Thalesardc/PBLE02/PBLE02/VH3/3D/LCD_visao1.JPG

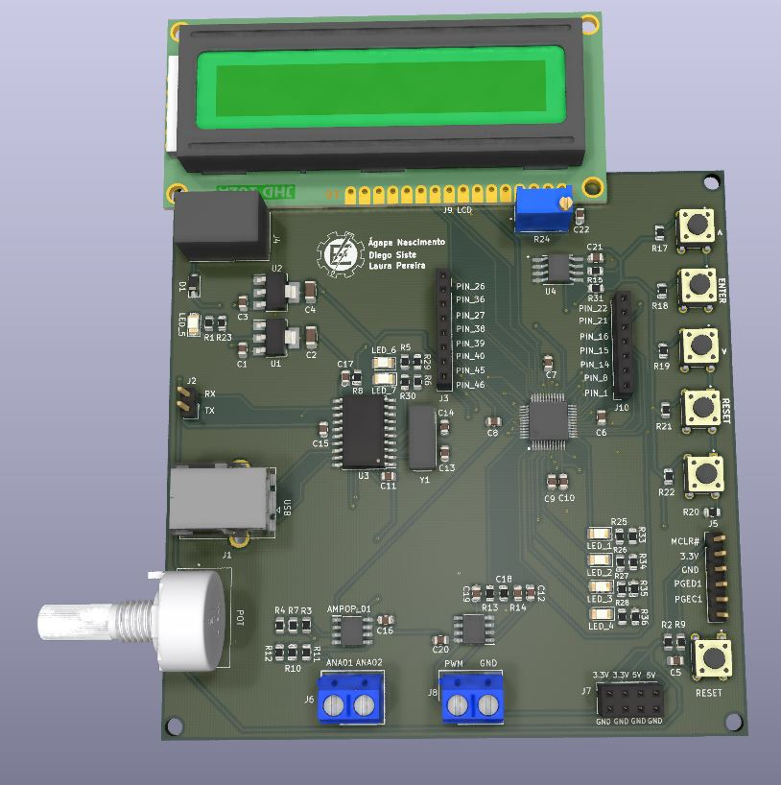
PBLE02/VH3/3D/LCD_visao1.JPG
