Thalesardc/PBLE02/PBLE02/VH3/3D/LCD_visao2.JPG

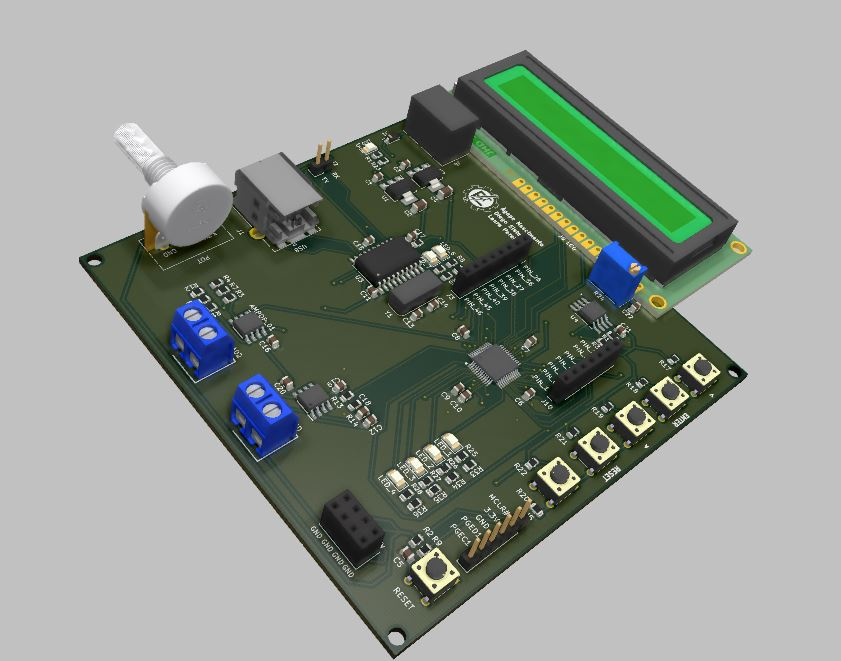
PBLE02/VH3/3D/LCD_visao2.JPG
