Thalesardc/PBLE02/PBLE02/VH3/3D/visao3D.JPG

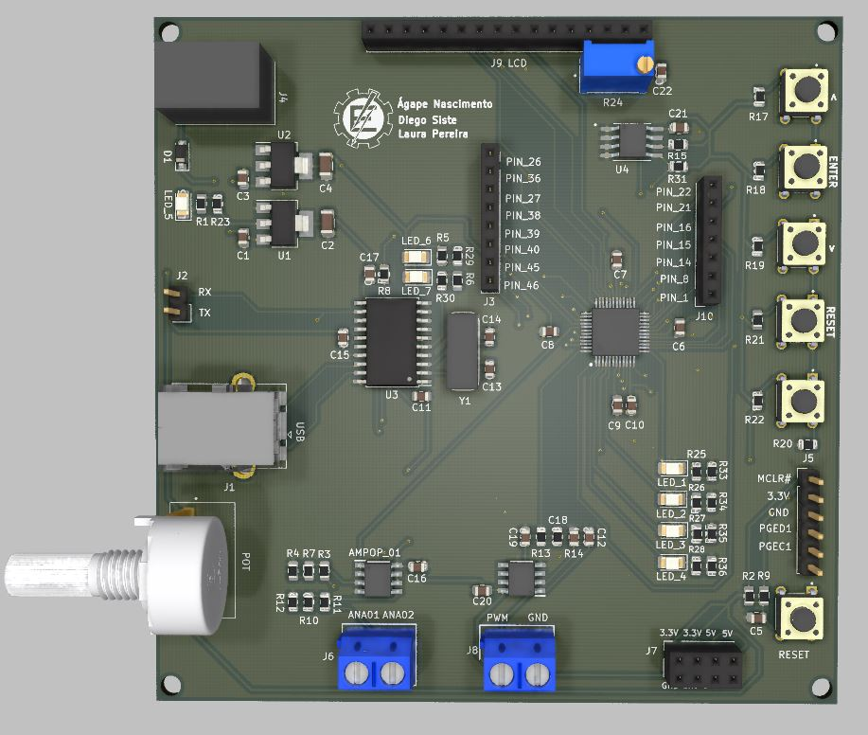
PBLE02/VH3/3D/visao3D.JPG
