Thalesardc/PBLE02/PBLE02/VH3/DIAGRAMAS/diagrama_de_estados.png

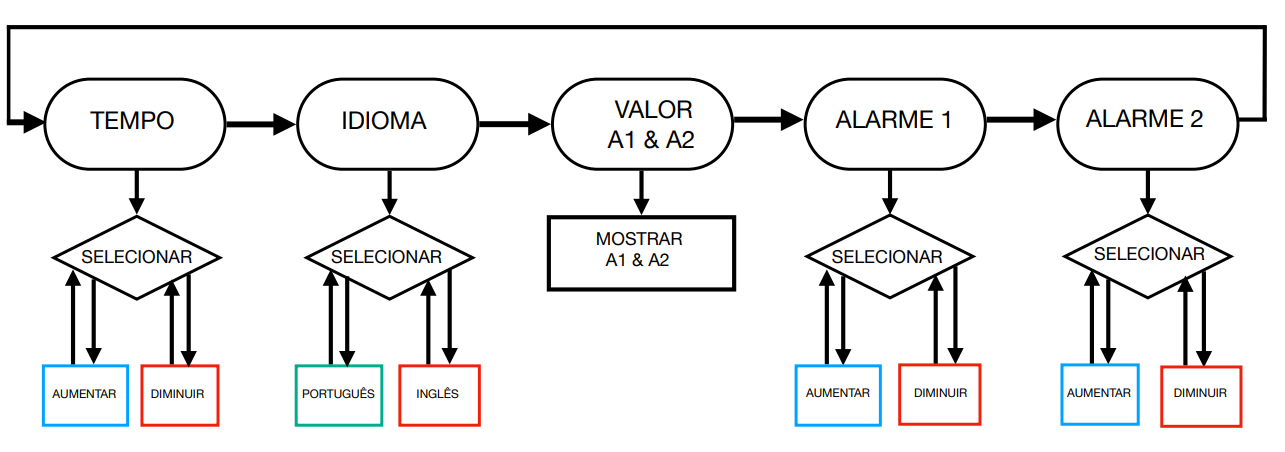
PBLE02/VH3/DIAGRAMAS/diagrama_de_estados.png
