Thalesardc/PBLE02/PBLE02/VH3/DIAGRAMAS/UML.jpeg

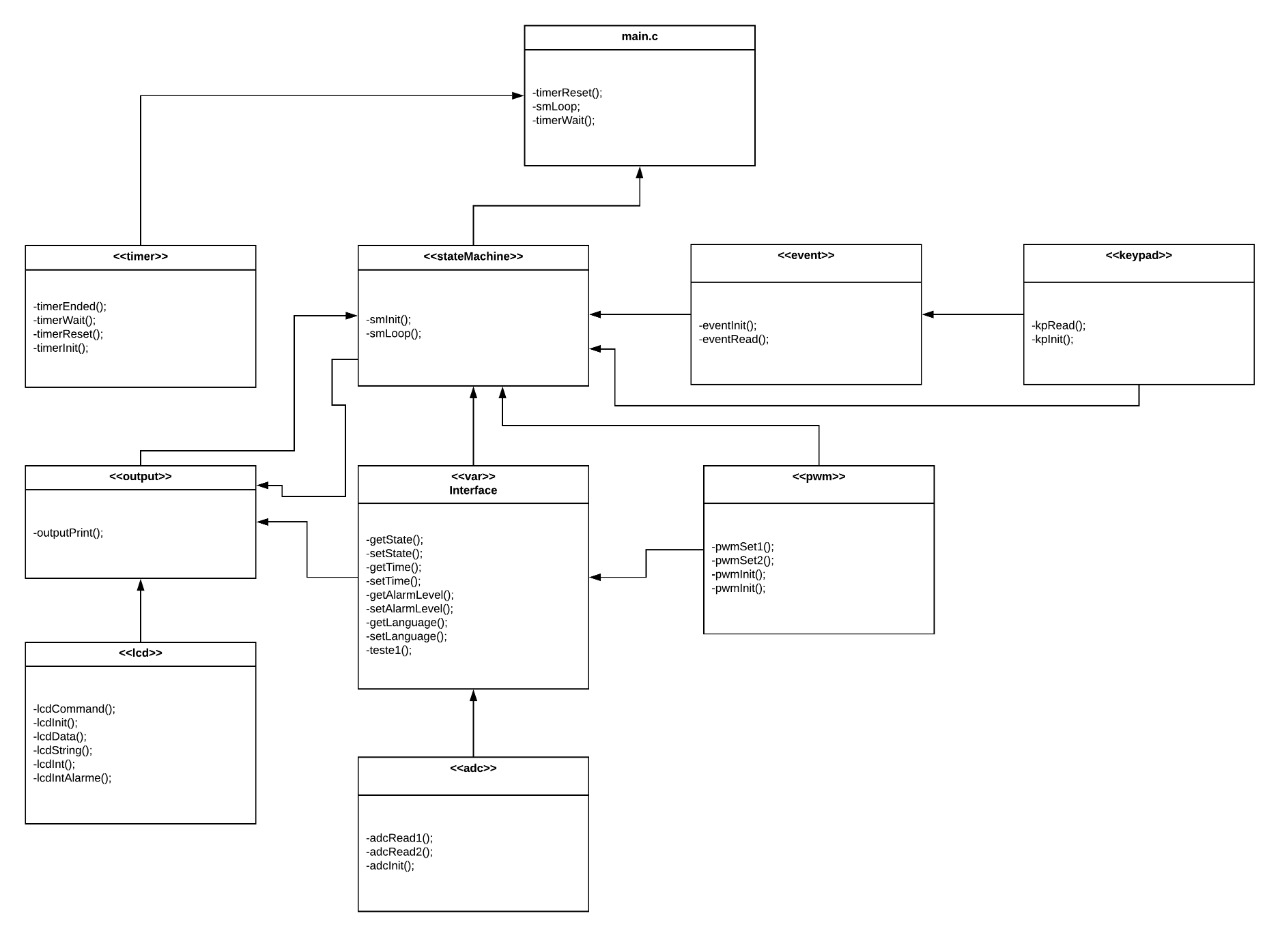
PBLE02/VH3/DIAGRAMAS/UML.jpeg
