Thalesardc/PBLE02/PBLE02/VH3/COMPONENTES/3D/PIC32MM0256GPM048-I_PT.stp

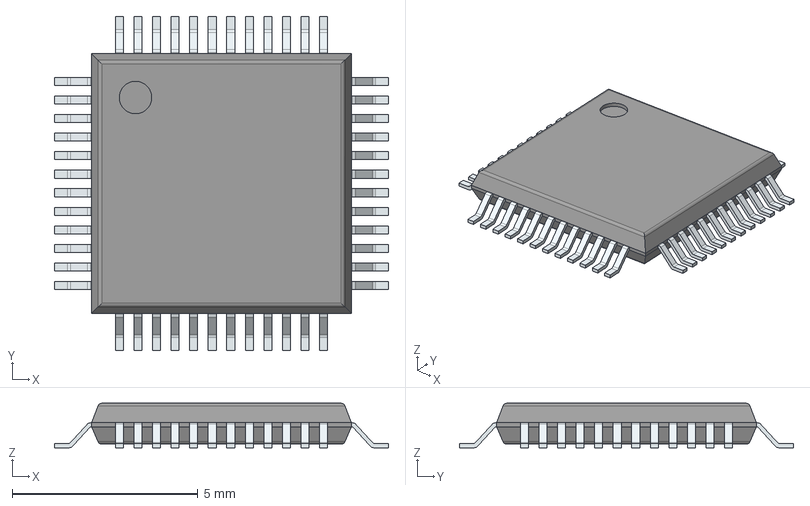
[picture p25: CAD file, 2022-07-13]
PBLE02/VH3/COMPONENTES/3D/PIC32MM0256GPM048-I_PT.stp
9.00 x 9.00 x 1.20 mm
PinsArrayLR
PinsArrayTB
