Thalesardc/PBLE02/PBLE02/VH3/COMPONENTES/3D/3296W-1-250--3DModel-STEP-56544.STEP

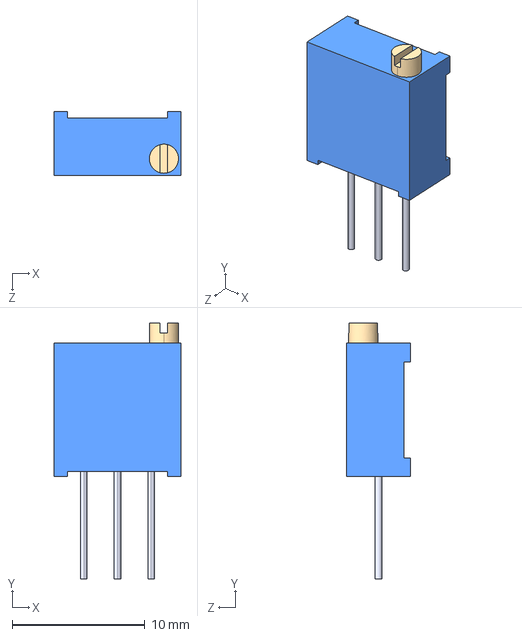
[picture p26: CAD file, 2022-07-13]
PBLE02/VH3/COMPONENTES/3D/3296W-1-250--3DModel-STEP-56544.STEP
9.53 x 19.3 x 4.83 mm
