Thalesardc/PBLE02/PBLE02/VH3/COMPONENTES/3D/CUI_DEVICES_PJ-002AH-SMT-TR.step

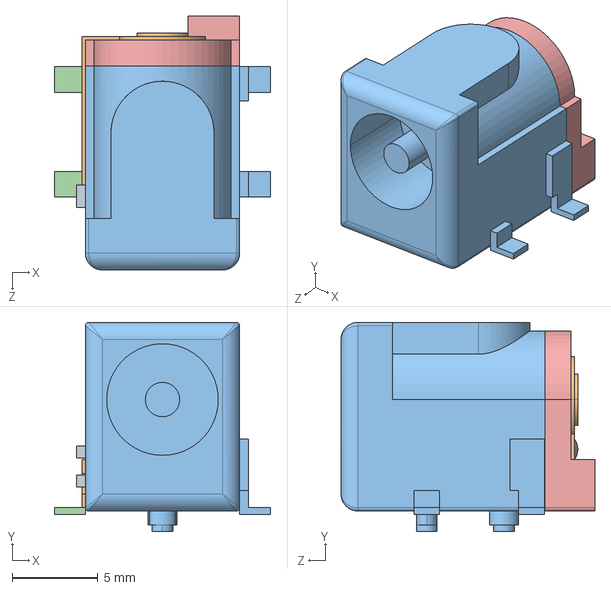
[picture p27: CAD file, 2022-07-13]
PBLE02/VH3/COMPONENTES/3D/CUI_DEVICES_PJ-002AH-SMT-TR.step
12.6 x 12.2 x 14.8 mm
