Thalesardc/PBLE02/PBLE02/VH3/COMPONENTES/3D/DPAK-L.step

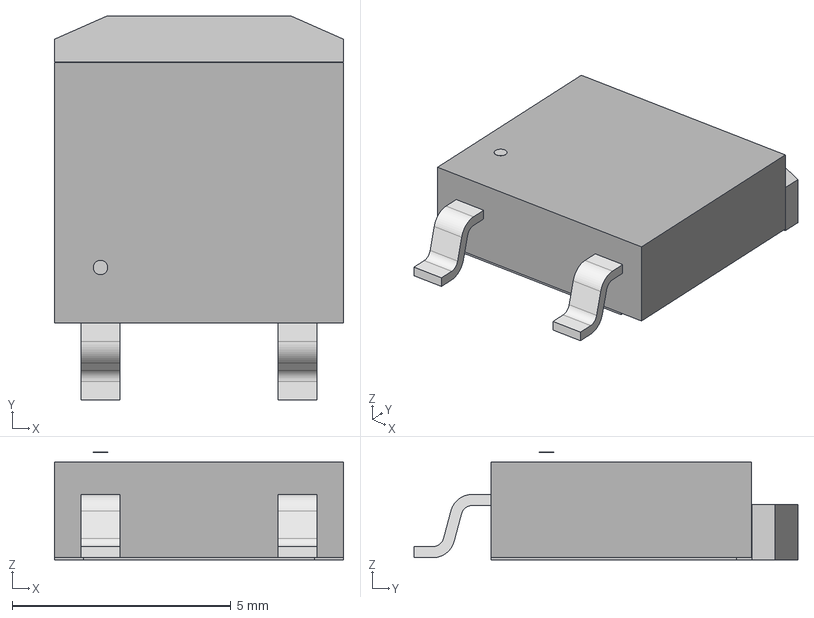
[picture p28: CAD file, 2022-07-13]
PBLE02/VH3/COMPONENTES/3D/DPAK-L.step
6.60 x 8.77 x 2.47 mm
