Thalesardc/PBLE02/PBLE02/VH3/COMPONENTES/3D/User Library-2_54mm Male Header (4x2).STEP

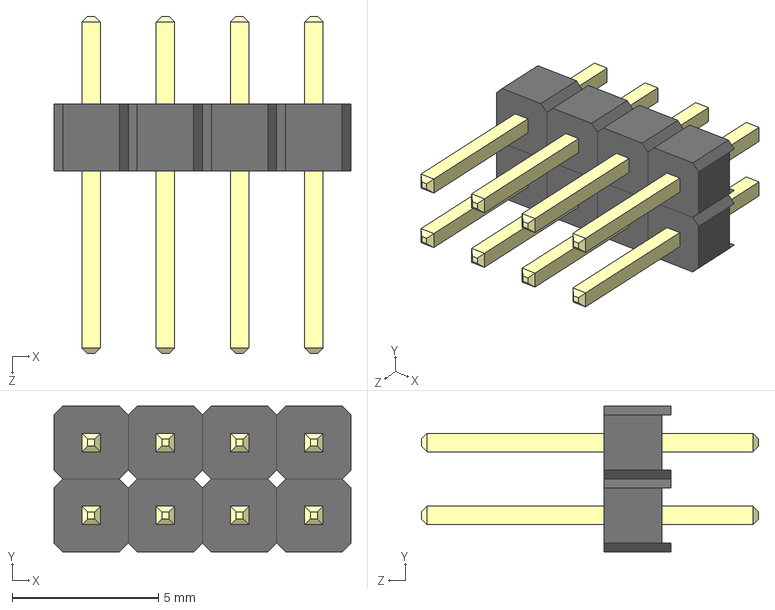
[picture p29: CAD file, 2022-07-13]
PBLE02/VH3/COMPONENTES/3D/User Library-2_54mm Male Header (4x2).STEP
10.2 x 4.98 x 11.5 mm
User Library-Header_Male_4Pin_PinArray x 2
User Library-Header_Male_4Pin_BodyArray x 2
