Thalesardc/PBLE02/PBLE02/VH3/COMPONENTES/3D/PJ-002AH.stp

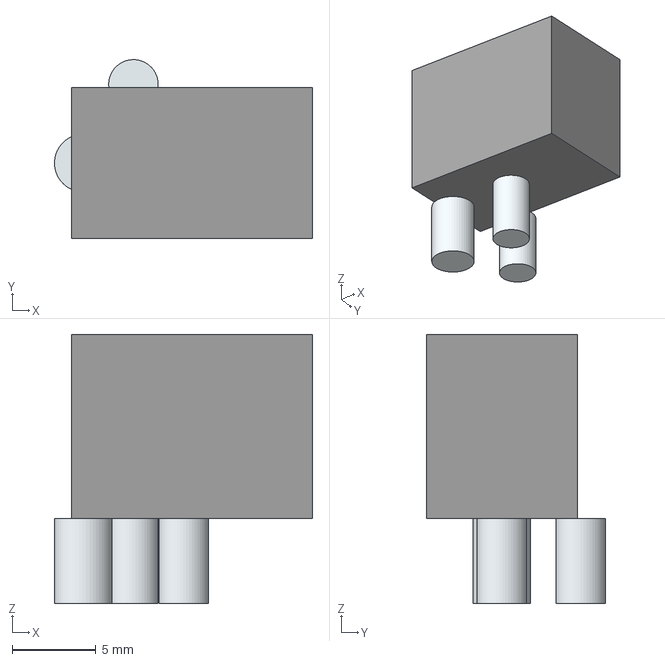
[picture p31: CAD file, 2022-07-13]
PBLE02/VH3/COMPONENTES/3D/PJ-002AH.stp
15.4 x 10.7 x 16.1 mm
Leads x 3
