Thalesardc/PBLE02/PBLE02/VH3/COMPONENTES/3D/47K Potenziometer.step

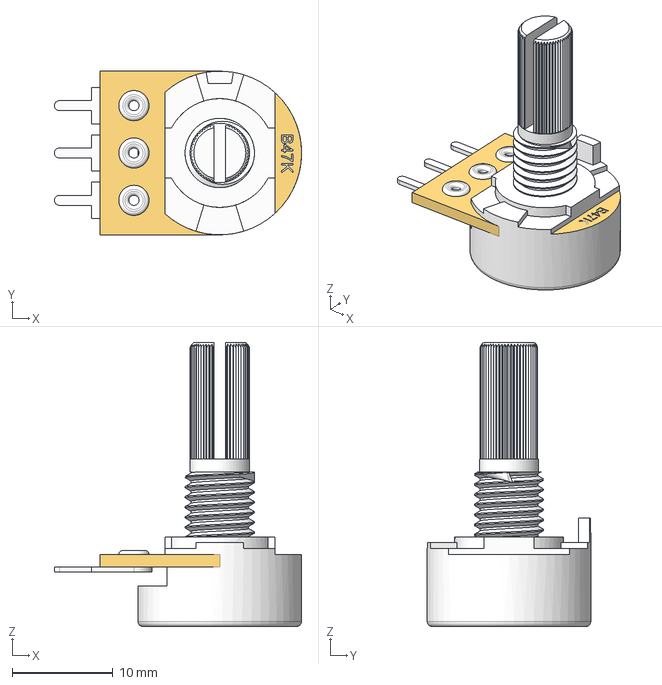
[picture p32: CAD file, 2022-07-13]
PBLE02/VH3/COMPONENTES/3D/47K Potenziometer.step
24.6 x 16.2 x 28.2 mm
