Thalesardc/PBLE02/PBLE02/VH3/COMPONENTES/3D/c-292304-1-b-3d.igs

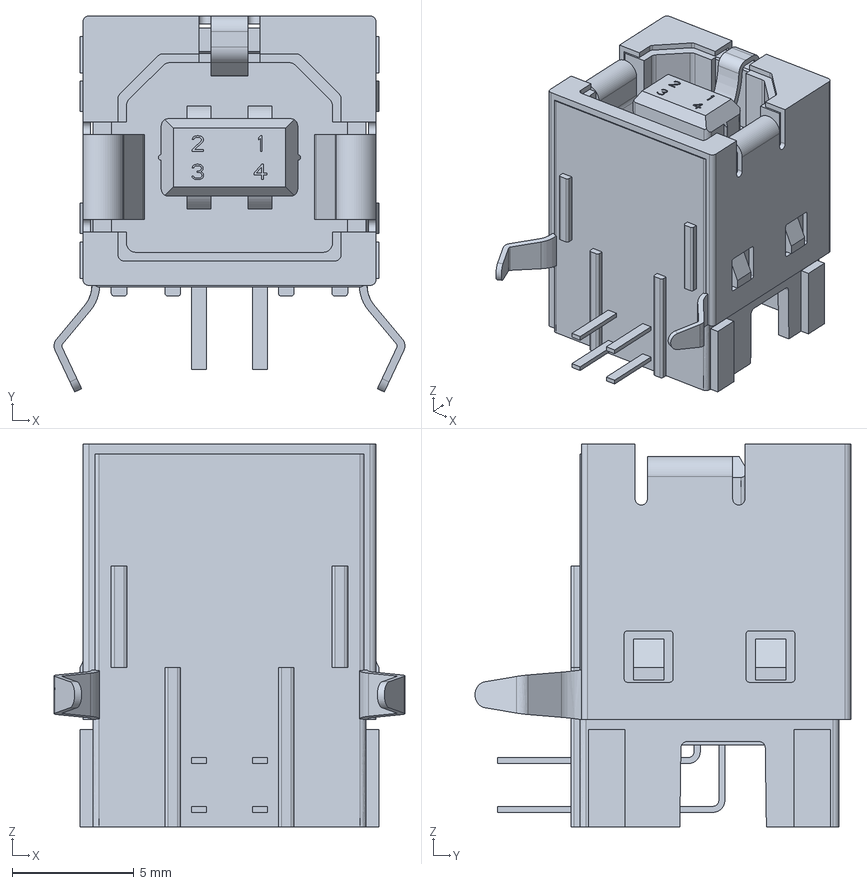
[picture p33: CAD file, 2022-07-13]
PBLE02/VH3/COMPONENTES/3D/c-292304-1-b-3d.igs
14.4 x 15.4 x 15.7 mm
