Thalesardc/PBLE02/PBLE02/VH3/COMPONENTES/3D/ATS12A.stp

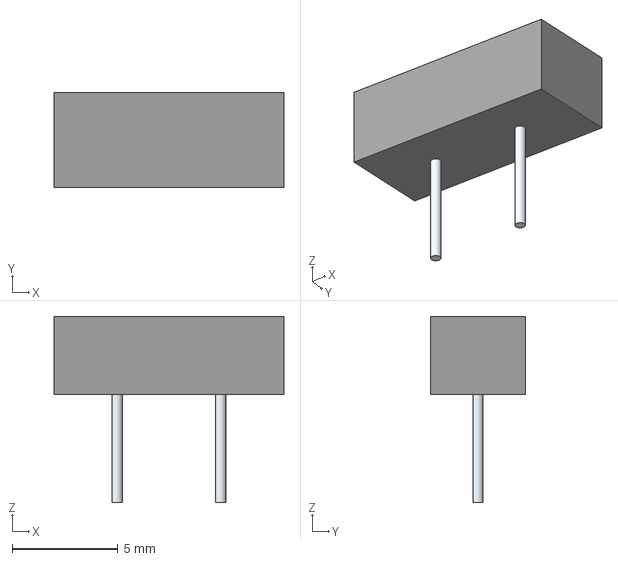
[picture p35: CAD file, 2022-07-13]
PBLE02/VH3/COMPONENTES/3D/ATS12A.stp
10.8 x 4.50 x 8.78 mm
Leads x 2
