Thalesardc/PBLE02/PBLE02/VH3/COMPONENTES/3D/LM358DG.stp

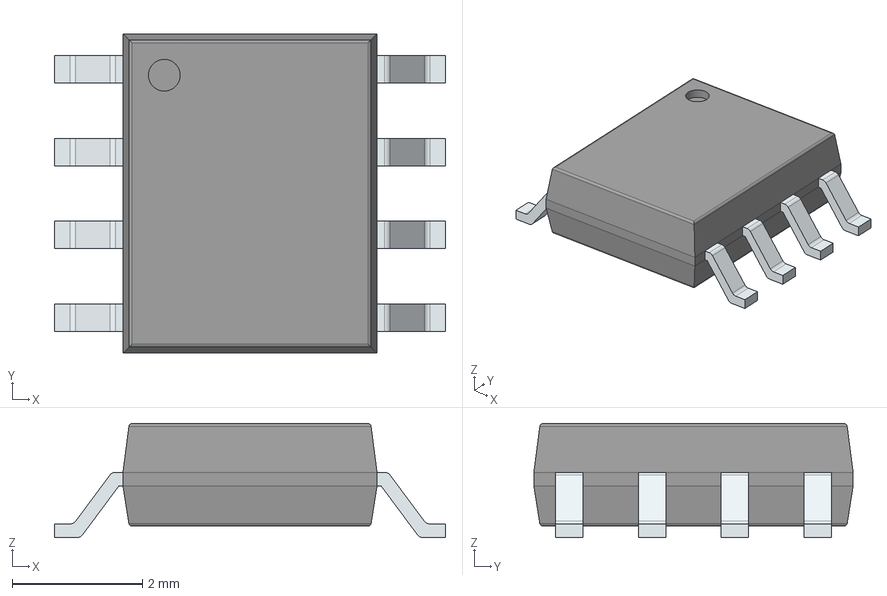
[picture p36: CAD file, 2022-07-13]
PBLE02/VH3/COMPONENTES/3D/LM358DG.stp
6.00 x 4.90 x 1.75 mm
PinsArrayLR
