Thalesardc/PBLE02/PBLE02/VH3/COMPONENTES/3D/User Library-LCD 16x2 JHD162A.STEP

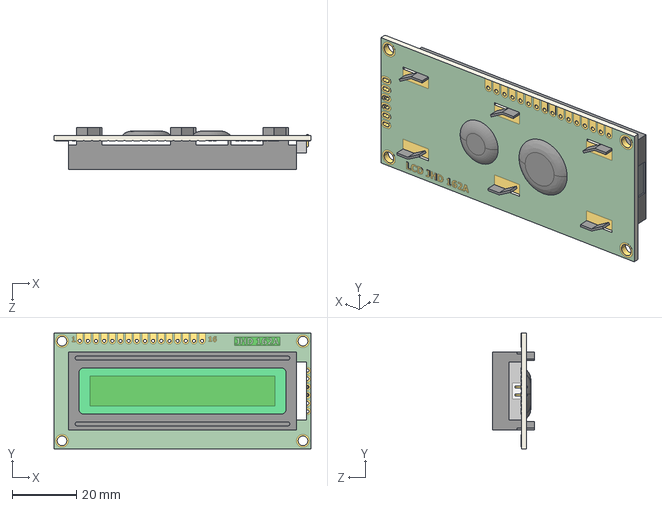
[picture p37: CAD file, 2022-07-13]
PBLE02/VH3/COMPONENTES/3D/User Library-LCD 16x2 JHD162A.STEP
80.0 x 36.0 x 13.2 mm
