Thalesardc/PBLE02/PBLE02/VH3/COMPONENTES/3D/1825910-6--3DModel-STEP-56544.STEP

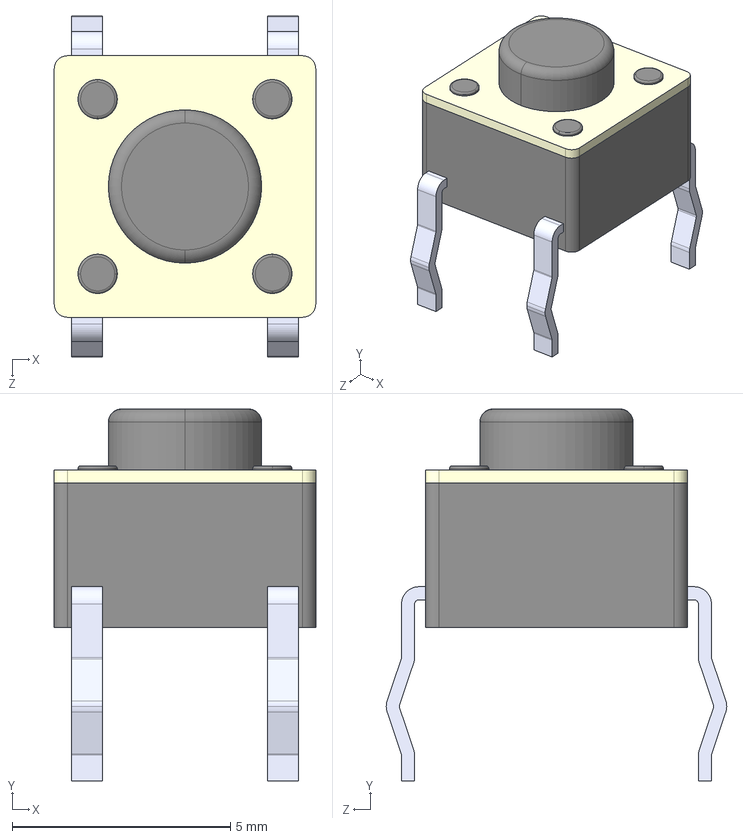
[picture p38: CAD file, 2022-07-13]
PBLE02/VH3/COMPONENTES/3D/1825910-6--3DModel-STEP-56544.STEP
5.99 x 8.52 x 7.80 mm
