Thalesardc/PBLE02/(list of files, cad)

Other CAD files:
PBLE02/VH3/COMPONENTES/3D/PJ-002AH.stl
