Thalesardc/PBLE02/PBLE02/Doc/MANUAL.pdf

# Manual do usuário

- Apresentação da placa | pág.02
- Instruções de uso | pág.03
- Contato dos desenvolvedores | pág.16

# Sobre a placa

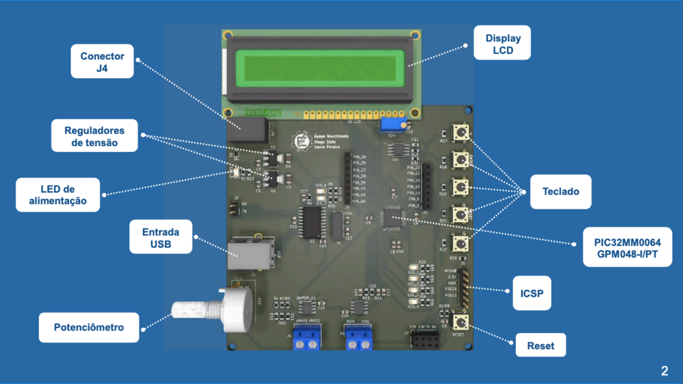
[picture p39: page 3]

•

# > = navega para direita

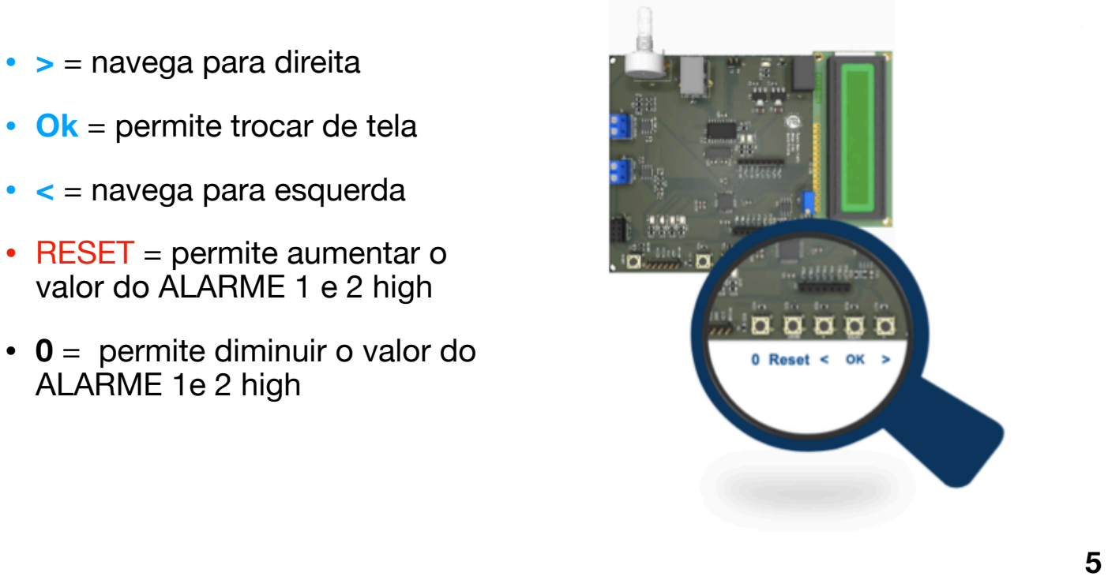
[picture p40: page 4]

# - Ok = permite trocar de tela • < = navega para esquerda • RESET = permite aumentar o

# valor do ALARME 1 e 2 high

•

# 0 = permite diminuir o valor do ALARME 1e 2 high

5

## - O usuário também pode trocar as telas via serial

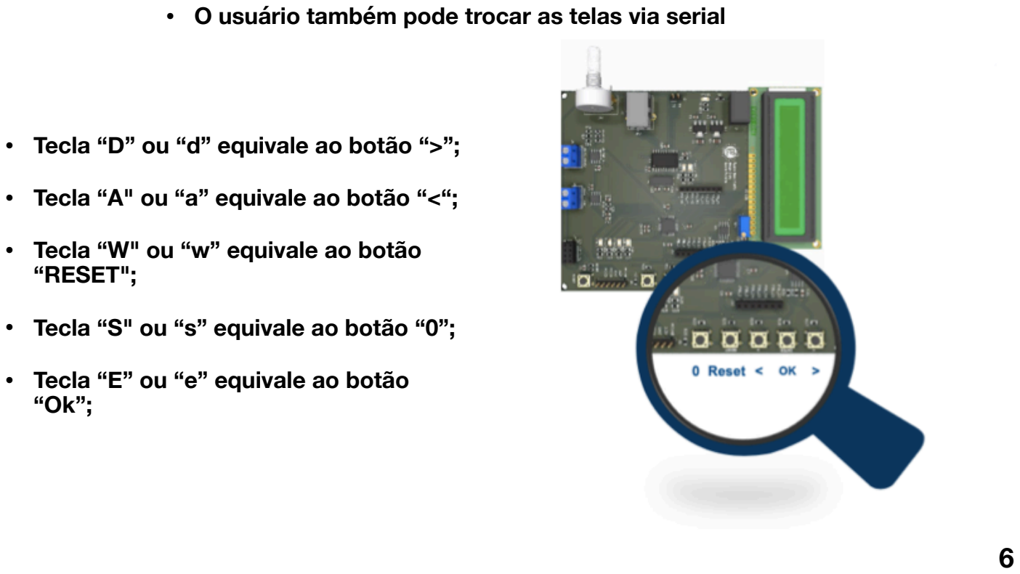
[picture p41: page 5]

- Tecla “D” ou “d” equivale ao botão “>”;
- Tecla “A" ou “a” equivale ao botão “<“;

## - Tecla “W" ou “w” equivale ao botão

“RESET";

- Tecla “S" ou “s” equivale ao botão “0”;

## - Tecla “E” ou “e” equivale ao botão

“Ok”;

6

## INSTRUÇÕES DE USO

Suporta tensão de entrada na faixa de 7 a 12V em corrente continua.

Compatível com conector Jack J4
de diâmetro interno de 2.1mm. | LED 5 sinaliza a presença de alimentação.

## ALIMENTAÇÃO

7

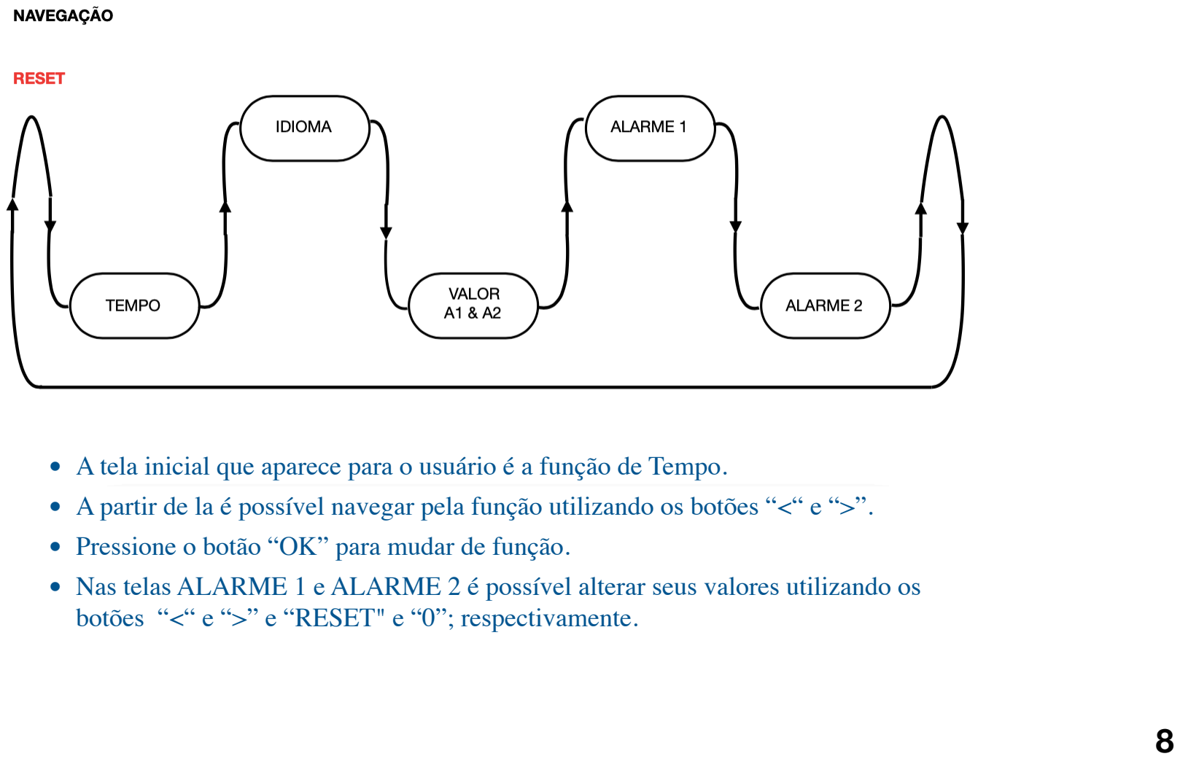
[picture p42: page 7]

- A tela inicial que aparece para o usuário é a função de Tempo.
- A partir de la é possível navegar pela função utilizando os botões “<“ e “>”.
- Pressione o botão “OK” para mudar de função.

### - Nas telas ALARME 1 e ALARME 2 é possível alterar seus valores utilizando os

botões “<“ e “>” e “RESET" e “0”; respectivamente.

8

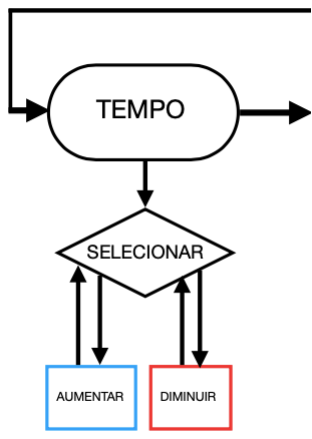
[picture p43: figure]

# - Na função tempo pode-se configurar o delay da máquina

de estado;

# Função Tempo

9

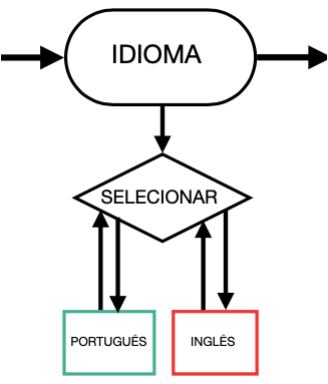
[picture p44: figure]

# - Na função idioma, a primeira tela

será a opção Português.
- Na segunda tela, será Inglês.

# - Para mudar as telas, utilize os botões "<" ou ">"

# Função Idioma

10

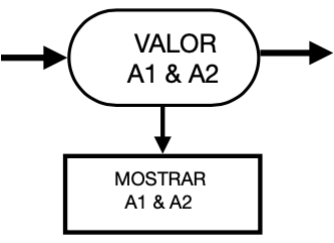
[picture p45: figure]

# - Na Função Valor A1 & A2 é exibido no LCD os valores lidos pelas entradas analógicas da

placa;

# Função Valor A1 & A2

11

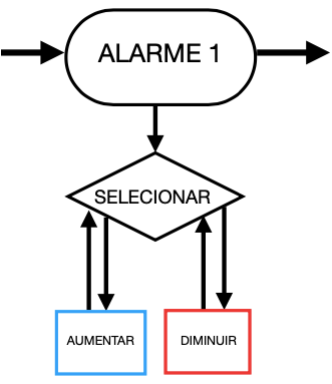
[picture p46: figure]

# - Na Função ALARME 1 e 2 low podemos utilizar as teclas "<" ou “>” para aumentar ou diminuir

seus parâmetros;

# Função ALARME 1

12

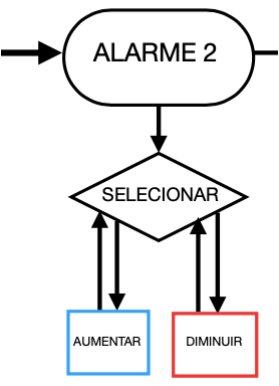
[picture p47: figure]

# - Na Função ALARME 1 e 2 high podemos utilizar as teclas "RESET" ou “0” para aumentar

ou diminuir seus parâmetros;

# Função ALARME 2

13

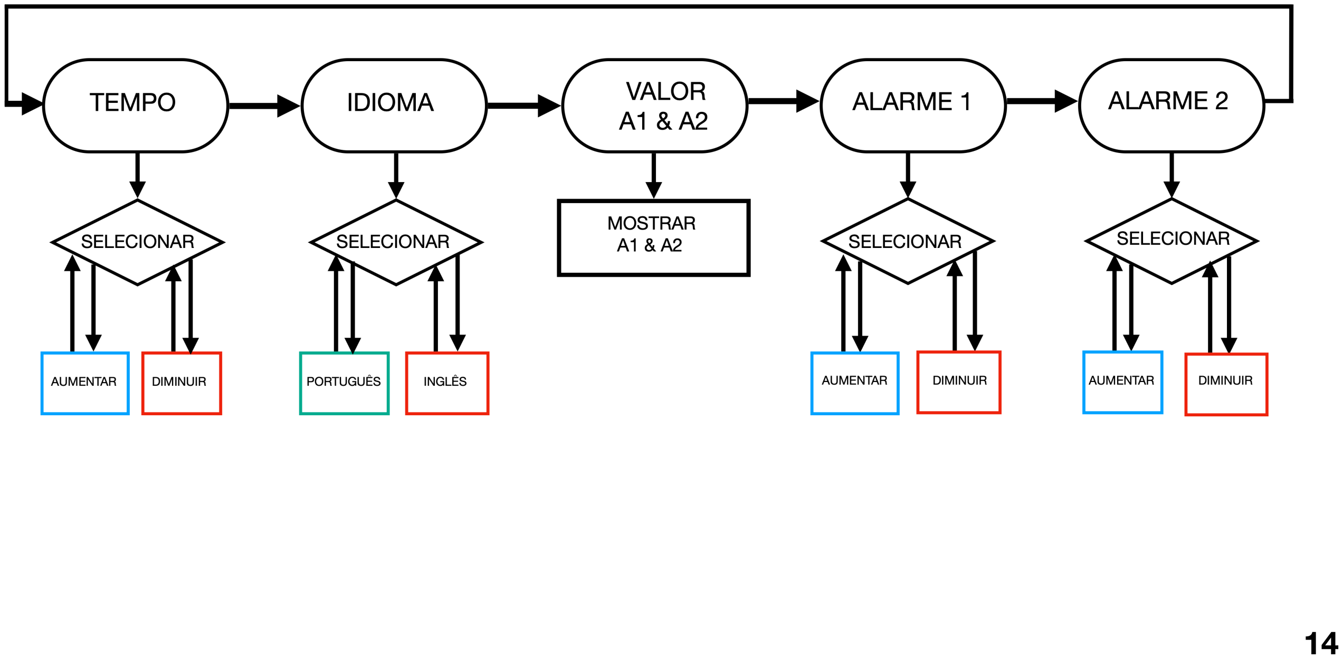
[picture p48: page 13]

14

# Protocolos via Serial

1) Para iniciar o protocolo é necessário utilizar o caractere “#”;
2) Para resetar o protocolo caso haja erro de digitação pode-se usar o caractere “.”;
3) Mensagem T1H “xxxx”;
Com este protocolo pode-se alterar o valor do ALARME 1 high, onde, “xxxx" é o valor digitado pelo usuário.
4) Mensagem T1L “xxxx”;
Com este protocolo pode-se alterar o valor do ALARME 1 low, onde, “xxxx" é o valor digitado pelo usuário.
5) Mensagem T2H “xxxx”;
Com este protocolo pode-se alterar o valor do ALARME 2 high, onde, “xxxx" é o valor digitado pelo usuário.
6) Mensagem T2L “xxxx”;
Com este protocolo pode-se alterar o valor do ALARME 2 low, onde, “xxxx" é o valor digitado pelo usuário.
7) Mensagem Y ”xxxx”;
Com este protocolo pode-se alterar o valor do TEMPO, onde, “xxxx" é o valor digitado pelo usuário.
8) Mensagem PT;
Com este protocolo pode-se alterar o idioma para Português.
9) Mensagem IN;
Com este protocolo pode-se alterar o idioma para Inglês.

15

## Montagem realizada por:

## ADEMILSON RAMOS - 2017019816 (ademilson@engenhariae.com.br) JOÃO CALIL - 2017020890 (jpclemos@unifei.edu.br) THALES CAMPOS - 2019005533 (thales-augusto10@gmail.com)

# OBRIGADO!
