Thalesardc/PBLE02/PBLE02/Doc/VH3_esquemático.pdf

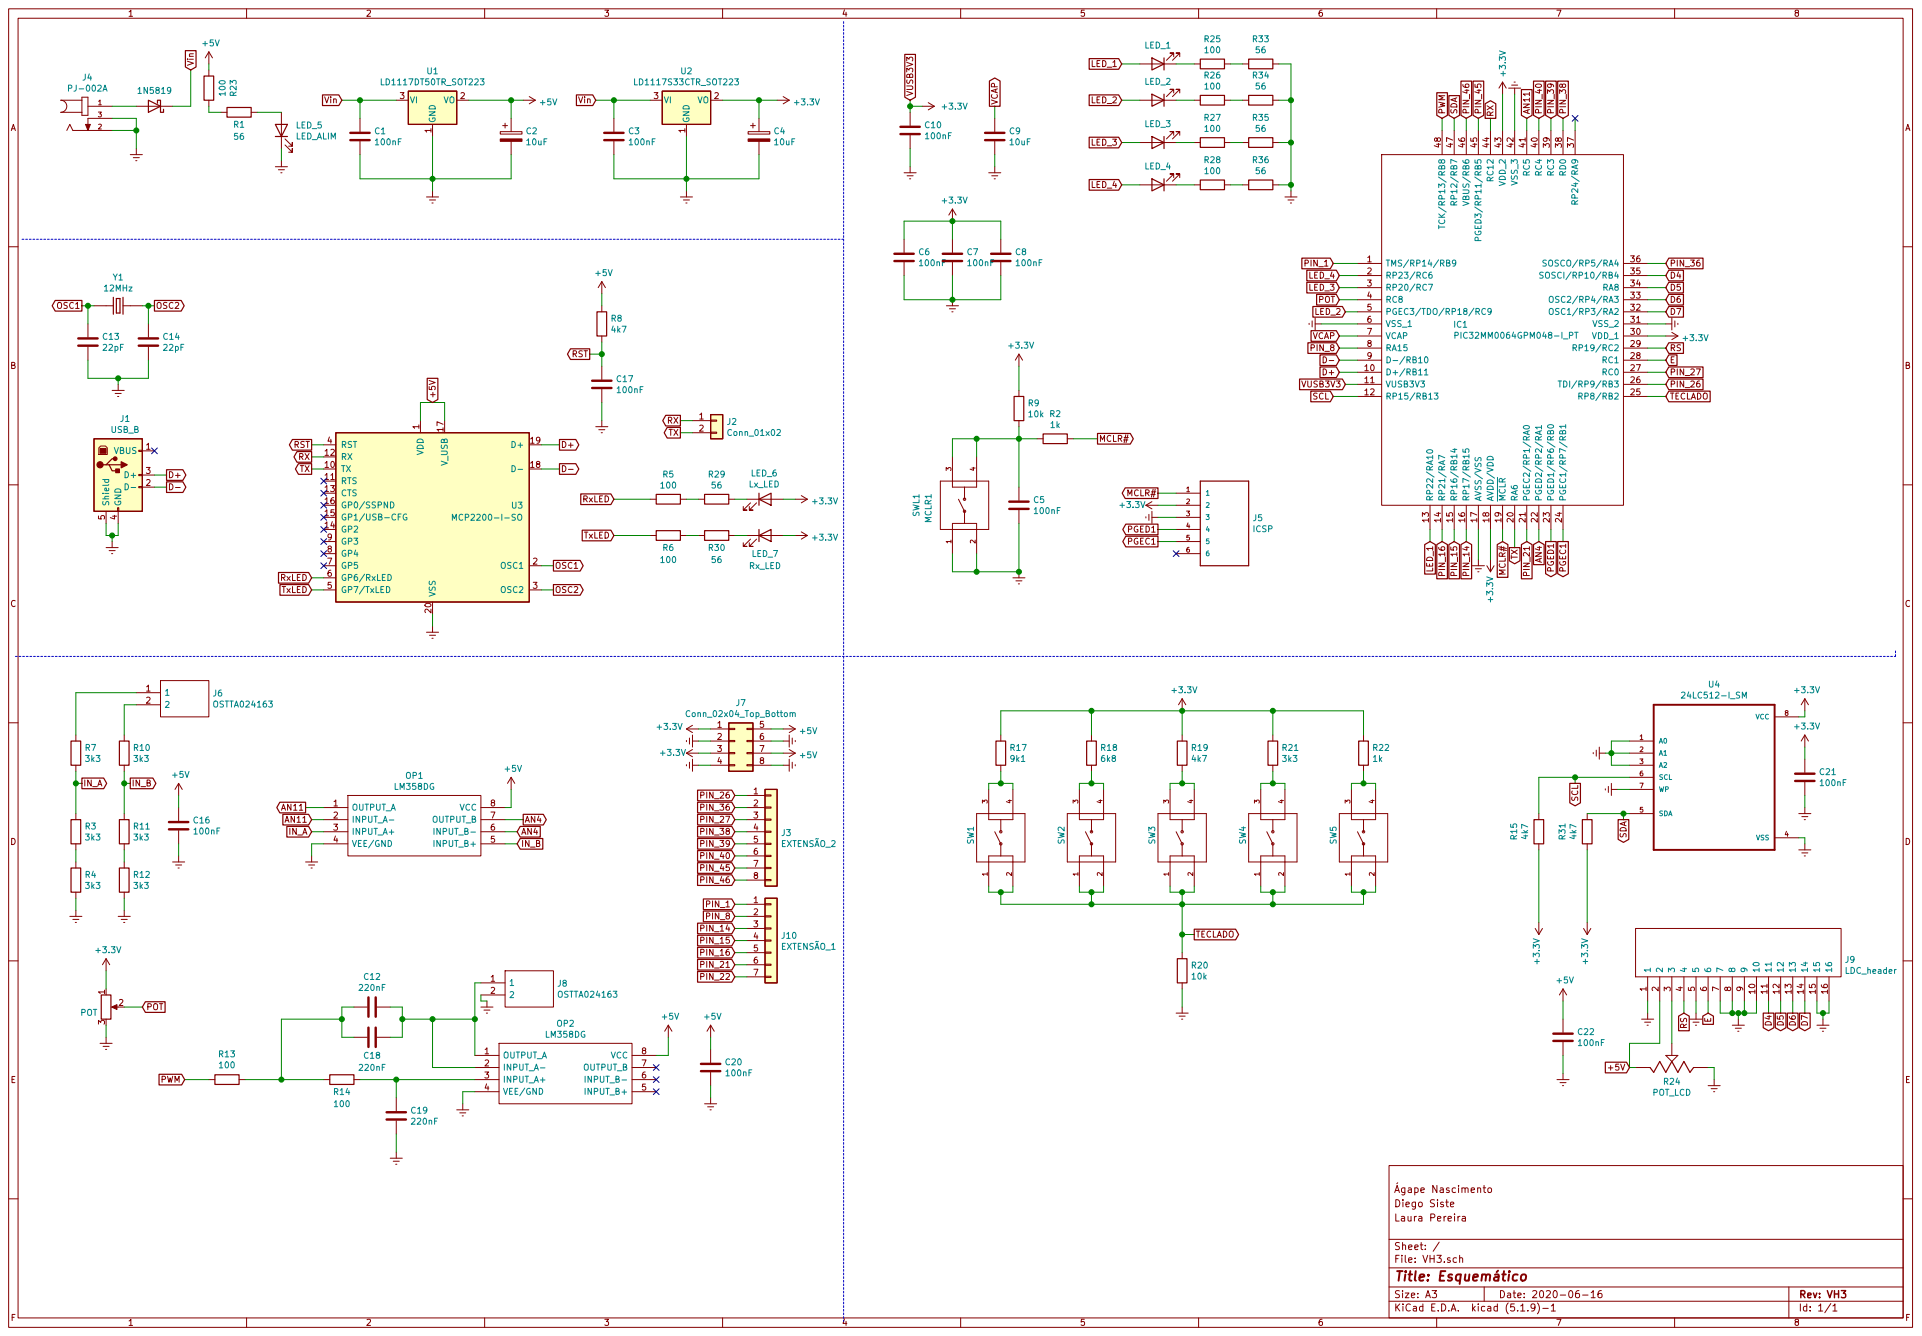
[picture p49: page 1]

4 SW3 TMS/RP14/RB9 1 D+/RB11 10 VUSB3V3 11 RP15/RB13 12 RP22/RA10 13 RP21/RA7 14 RP16/RB14 15 RP17/RB15 16 AVSS/VSS 17 AVDD/VDD 18 MCLR 19 RP23/RC6 2 RA6 20 PGEC2/RP1/RA0 21 PGED2/RP2/RA1 22 PGED1/RP6/RB0 23 PGEC1/RP7/RB1 24 RP8/RB2 25 TDI/RP9/RB3 26 RC0 27 RC1 28 RP19/RC2 29 RP20/RC7 3 VDD_1 30 VSS_2 31 OSC1/RP3/RA2 32 OSC2/RP4/RA3 33 RA8 34 SOSCI/RP10/RB4 35 SOSCO/RP5/RA4 36 RP24/RA9 37 RD0 38 RC3 39 RC8 4 RC4 40 RC5 41 VSS_3 42 VDD_2 43 RC12 44 PGED3/RP11/RB5 45 VBUS/RB6 46 RP12/RB7 47 TCK/RP13/RB8 48 PGEC3/TDO/RP18/RC9 5 VSS_1 6 VCAP 7 RA15 8 D-/RB10 9

1 TX 10 RTS 11 RX 12 CTS 13 GP2 14 GP1/USB-CFG 15 GP0/SSPND 16 V_USB 17 D- 18 D+ 19 OSC1 2 VSS 20 OSC2 3 RST 4 GP7/TxLED 5 GP6/RxLED 6 GP5 7 GP4 8 GP3 9 U3 MCP2200-I-SO

Ágape Nascimento
File: VH3.sch Sheet: / Laura Pereira Diego Siste
