Thalesardc/PBLE02/PBLE02/VH3/VH3/VH3.kicad_pcb

## KiCad design PBLE02/VH3/VH3/VH3.kicad_pcb (2022-07-13)

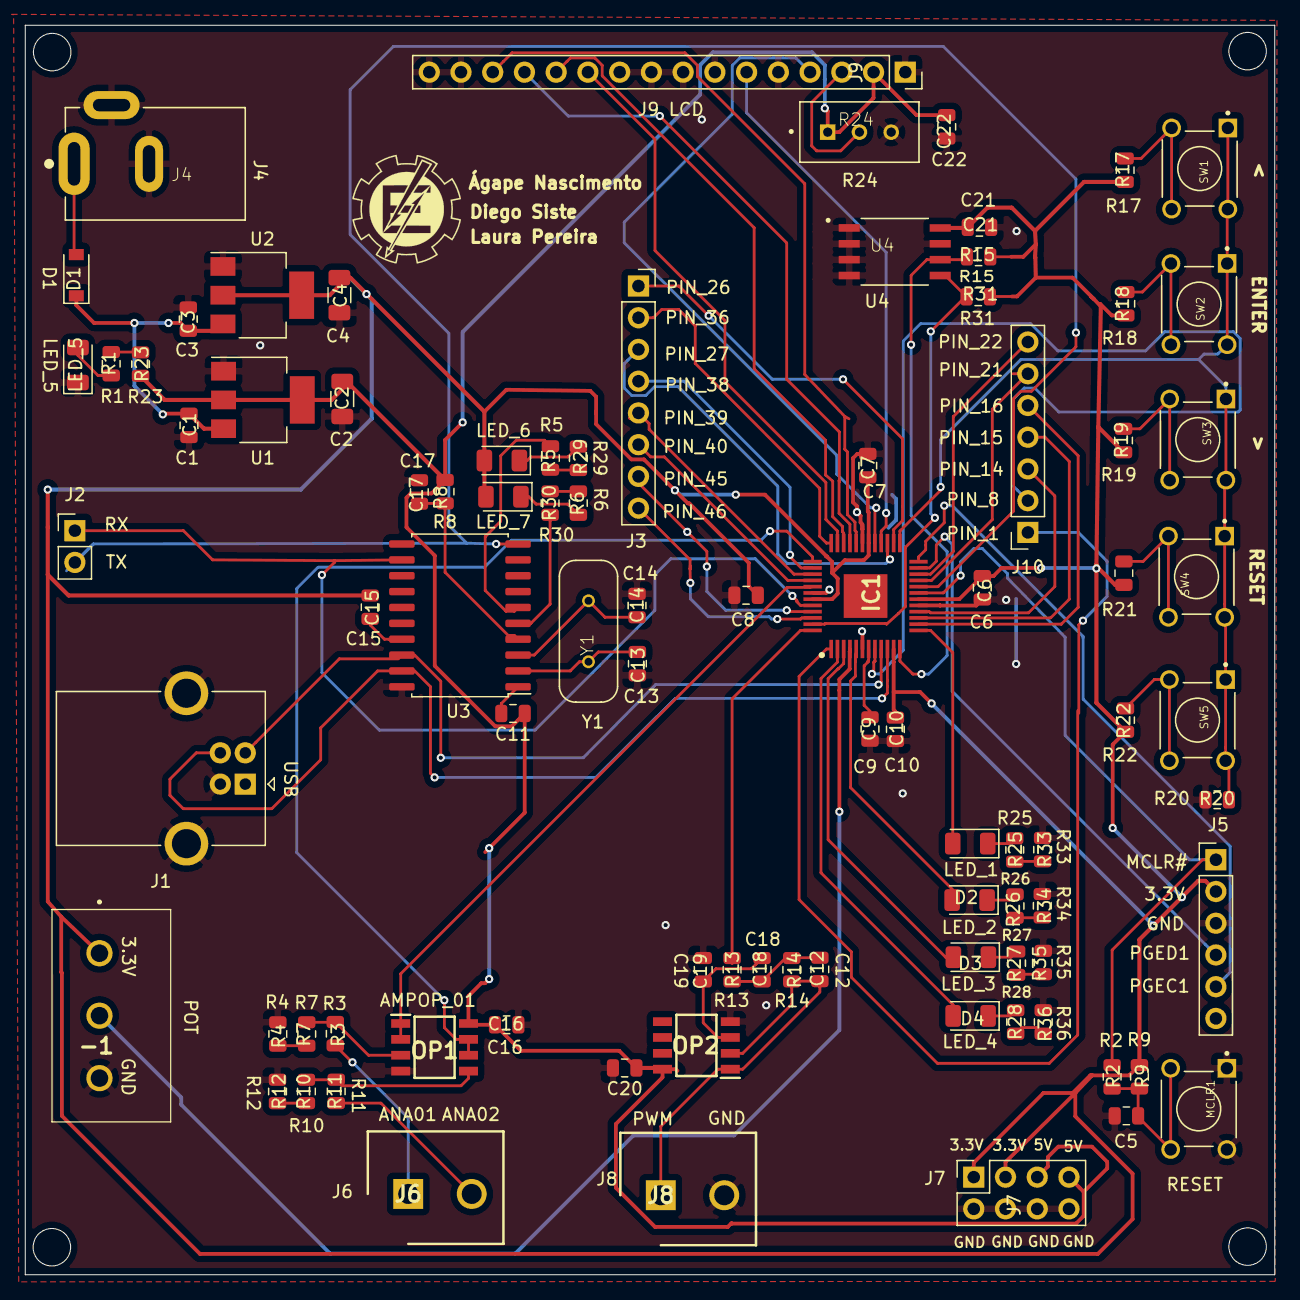
[picture p50: board VH3.kicad_pcb from above]

Board: 2 copper layers, 100.0 x 100.0 mm, 90 parts (0 on the bottom side), 82 nets.

Parts:
-1: POT; P160KN0QD15B10K
C1, C3, C5, C6, C7, C8, C10, C11, C15, C16, C17, C20, C21, C22: 100nF; C_0805_2012Metric
C2, C4: 10uF; C_1206_3216Metric
C9: 10uF; C_0805_2012Metric
C12, C18, C19: 220nF; C_0805_2012Metric
C13, C14: 22pF; C_0805_2012Metric
D1: 1N5819; D_SOD-123
D2: LED_2; LED_1206_3216Metric
D3: LED_3; LED_1206_3216Metric
D4: LED_4; LED_1206_3216Metric
IC1: PIC32MM0064GPM048-I_PT; QFP50P900X900X120-49N
J1: USB_B; USB_B_OST_USB-B1HSxx_Horizontal
J2: Conn_01x02; PinHeader_1x02_P2.54mm_Vertical
J3: EXTENSÃO_2; PinSocket_1x08_P2.54mm_Vertical
J4: PJ-002A; CUI_PJ-002A
J5: ICSP; PinHeader_1x06_P2.54mm_Vertical
J6, J8: OSTTA024163; SHDR2W100P0X508_1X2_1086X900X1300P
J7: Conn_02x04_Top_Bottom; PinSocket_2x04_P2.54mm_Vertical
J9: LDC_header; PinSocket_1x16_P2.54mm_Vertical
J10: EXTENSÃO_1; PinSocket_1x07_P2.54mm_Vertical
LED_1: LED_1; LED_1206_3216Metric
LED_5: LED_ALIM; LED_1206_3216Metric
LED_6: Lx_LED; LED_1206_3216Metric
LED_7: Rx_LED; LED_1206_3216Metric
MCLR1: SWL1; SW_1825910-6-4
OP1, OP2: LM358DG; SOIC127P600X175-8N
R1, R29, R30, R33, R34, R35, R36: 56; R_0805_2012Metric
R2, R22: 1k; R_0805_2012Metric
R3, R4, R7, R10, R11, R12, R21: 3k3; R_0805_2012Metric
R5, R6, R13, R14, R23, R25, R26, R27, R28: 100; R_0805_2012Metric
R8, R15, R19, R31: 4k7; R_0805_2012Metric
R9, R20: 10k; R_0805_2012Metric
R17: 9k1; R_0805_2012Metric
R18: 6k8; R_0805_2012Metric
R24: POT_LCD; TRIM_3296W-1-103RLF
SW1, SW2, SW3, SW4, SW5: 1825910-6; SW_1825910-6-4
U1: LD1117DT50TR_SOT223; SOT-223-3_TabPin2
U2: LD1117S33CTR_SOT223; SOT-223-3_TabPin2
U3: MCP2200-I-SO; SOIC-20W_7.5x12.8mm_P1.27mm
U4: 24LC512-I_SM; SOIC127P794X202-8N
Y1: 12MHz; XTAL_ECS-120-20-4X
ee: LOGO; unifei_logo

Connections:
+5V: C2.1, C11.1, C16.1, C20.1, C22.1, J7.5, J7.7, J9.2, OP1.8, OP2.8, R8.1, R23.2, R24.1, U1.2
AN4: IC1.37, OP1.6, OP1.7
AN11: IC1.41, OP1.1, OP1.2
D4: IC1.35, J9.11
D5: IC1.34, J9.12
D6: IC1.33, J9.13
D7: IC1.32, J9.14
D+: IC1.10, J1.3, U3.19
D-: IC1.9, J1.2, U3.18
E: IC1.28, J9.6
Earth: -1.3, C1.2, C2.2, C3.2, C4.2, C5.2, C6.2, C7.2, C8.2, C9.2, C10.2, C13.2, C14.2, C16.2, C17.2, C19.2, C20.2, C21.2, C22.2, IC1.6, IC1.17, IC1.31, IC1.42, J1.4, J1.5, J4.2, J4.3, J5.3, J7.2, J7.4, J7.6, J7.8, J8.2, J9.1, J9.5, J9.7, J9.8, J9.9, J9.10, J9.15, J9.16, LED_5.1, MCLR1.1, MCLR1.2, OP1.4, OP2.4, R4.2, R12.2, R20.2, R24.3, R33.1, R34.1, R35.1, R36.1, U1.1, U2.1, U3.20, U4.1, U4.2, U4.3, U4.4, U4.7
IN_A: OP1.3, R3.1, R7.2
IN_B: OP1.5, R10.2, R11.1
LED_1: IC1.13, LED_1.2
LED_2: D2.2, IC1.5
LED_3: D3.2, IC1.3
LED_4: D4.2, IC1.2
MCLR#: IC1.19, J5.1, R2.1
unnamed: C5.1, MCLR1.3, MCLR1.4, R2.2, R9.2
unnamed: C11.2, U3.1
unnamed: C12.1, C18.1, J8.1, OP2.1, OP2.2
unnamed: C12.2, C18.2, R13.2, R14.2
unnamed: C15.2, U3.17
unnamed: C19.1, OP2.3, R14.1
unnamed: D1.2, J4.1
unnamed: D2.1, R26.2
unnamed: D3.1, R27.2
unnamed: D4.1, R28.2
unnamed: J6.1, R7.1
unnamed: J6.2, R10.1
unnamed: J9.3, R24.2
unnamed: LED_1.1, R25.2
unnamed: LED_5.2, R1.1
unnamed: LED_6.1, R29.1
unnamed: LED_7.1, R30.1
unnamed: R1.2, R23.1
unnamed: R3.2, R4.1
unnamed: R11.2, R12.1
unnamed: R17.2, SW1.3, SW1.4
unnamed: R18.2, SW2.3, SW2.4
unnamed: R19.2, SW3.3, SW3.4
unnamed: R21.2, SW4.3, SW4.4
unnamed: R22.2, SW5.3, SW5.4
unnamed: R25.1, R33.2
unnamed: R26.1, R34.2
unnamed: R27.1, R35.2
unnamed: R28.1, R36.2
unnamed: R5.1, R29.2
unnamed: R6.1, R30.2
OSC1: C13.1, U3.2, Y1.1
OSC2: C14.1, U3.3, Y1.2
PGEC1: IC1.24, J5.5
PGED1: IC1.23, J5.4
PIN_1: IC1.1, J10.1
PIN_8: IC1.8, J10.2
PIN_14: IC1.16, J10.3
PIN_15: IC1.15, J10.4
PIN_16: IC1.14, J10.5
PIN_21: IC1.21, J10.6
PIN_22: IC1.22, J10.7
PIN_26: IC1.26, J3.1
PIN_27: IC1.27, J3.3
PIN_36: IC1.36, J3.2
PIN_38: IC1.38, J3.4
PIN_39: IC1.39, J3.5
PIN_40: IC1.40, J3.6
PIN_45: IC1.45, J3.7
PIN_46: IC1.46, J3.8
POT: -1.2, IC1.4
PWM: IC1.48, R13.1
RS: IC1.29, J9.4
RST: C17.1, R8.2, U3.4
RX: IC1.44, J2.1, U3.12
RxLED: R5.2, U3.6
SCL: IC1.12, R15.1, U4.6
SDA: IC1.47, R31.1, U4.5
TECLADO: IC1.25, R20.1, SW1.1, SW1.2, SW2.1, SW2.2, SW3.1, SW3.2, SW4.1, SW4.2, SW5.1, SW5.2
TX: IC1.20, J2.2, U3.10
TxLED: R6.2, U3.5
VCAP: C9.1, IC1.7
VUSB3V3: -1.1, C4.1, C6.1, C7.1, C8.1, C10.1, C15.1, C21.1, IC1.11, IC1.18, IC1.30, IC1.43, J5.2, J7.1, J7.3, LED_6.2, LED_7.2, R9.1, R15.2, R17.1, R18.1, R19.1, R21.1, R22.1, R31.2, U2.2, U4.8
Vin: C1.1, C3.1, D1.1, U1.3, U2.3
