Thalesardc/PBLE02/PBLE02/SW3/teste.X/keypad.c

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
#include "keypad.h"
#include "mcc_generated_files/adc1.h"

//static unsigned char valor = 0x00;

unsigned int kpRead(void) {
    int conversion;
    ADC1_Initialize();
    ADC1_ChannelSelect(TECLADO);
    ADC1_Start();
    //Provide Delay
    for(int i=0;i <1000;i++)
    {
    }
    ADC1_Stop();
    while(!ADC1_IsConversionComplete())
    {
        ADC1_Tasks();   
    }
    conversion = ADC1_ConversionResultGet(); // Pega Analógico convertido para Digital
    return conversion;
}

//void kpDebounce(void) {
//    unsigned char i, j;
//    static unsigned char tempo;
//    static unsigned char valorNovo = 0x0000;
//    static unsigned char valorAntigo = 0x0000;
//
//    for (i = 0; i < 4; i++) {
//        TRISB = ~((unsigned char)1<<i);
//        PORTB = ~((unsigned char)1<<i);
//
//        //realiza o teste para cada bit e atualiza a variável
//        for (j = 0; j < 2; j++) {
//            if (!BitTst(PORTB, j + 4)) {
//                BitSet(valorNovo, (i * 2) + j);
//            } else {
//                BitClr(valorNovo, (i * 2) + j);
//            }
//        }
//    }
//    if (valorAntigo == valorNovo) {
//        tempo--;
//    } else {
//        tempo = 10;
//        valorAntigo = valorNovo;
//    }
//    if (tempo == 0) {
//        valor = valorAntigo;
//    }
//}
//
