Thalesardc/PBLE02/PBLE02/SW3/teste.X/lcd.h

#ifndef _LCD_H
#define _LCD_H

void delayMS(unsigned char ms); 
void pulseEnablePin();
void pushNibble(int value, int rs);
void pushByte(int value, int rs); 
void lcdChar(int value); 
void lcdCommand(int value);
void lcdCommand4bits(int nibble);
void lcdInit();
void lcdString(char msg[]);
void lcdData(unsigned char value);
void lcdIntLevel (int val);
void lcdIntTime (int val);
void lcdIntTimeSeconds (int val);
void lcdIntDate (int val);
void lcdDefconLogo (void);

#endif	// _LCD_H}
