Thalesardc/PBLE02/(notices)

Notices in the files:
PBLE02/SW3/teste.X/pwm.c:
Copyright (C) Rodrigo Almeida 2010
Licença: GNU GPL 2
This program is free software; you can redistribute it and/or modify
it under the terms of the GNU General Public License as published by
the Free Software Foundation; version 2 of the License.
PBLE02/SW3/teste.X/keypad.c:
Copyright (C) Rodrigo Almeida 2014
